gardners/megaphone-r5-modular/fonts/noto/README.txt

To download these fonts go to:

https://fonts.google.com/noto/specimen/Noto+Emoji

Then click on "Get Font", then "Download All (3)".

It's annoying that there is no direct link for them!
