gardners/megaphone-r5-modular/modules/bluetooth/footprints/BM83SM1-00AA.step

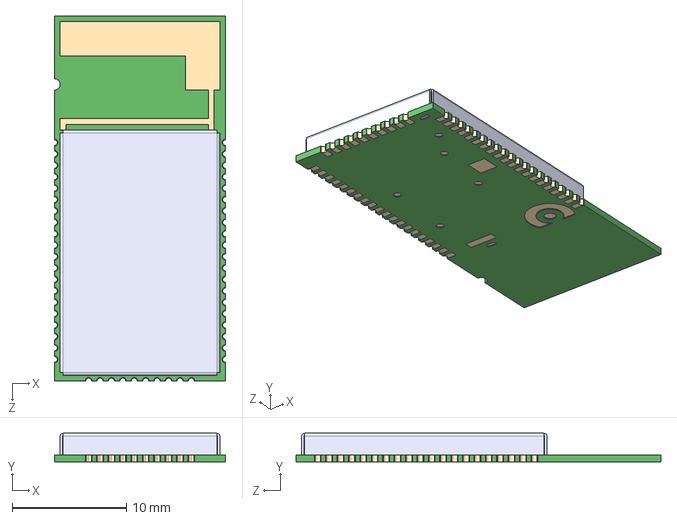
[picture p1: CAD file, 2025-04-25]
modules/bluetooth/footprints/BM83SM1-00AA.step
15.0 x 2.50 x 32.0 mm
