gardners/megaphone-r5-modular/modules/input-power-selector/footprints/SOIC_09DY-T1-GE3_VIS.step

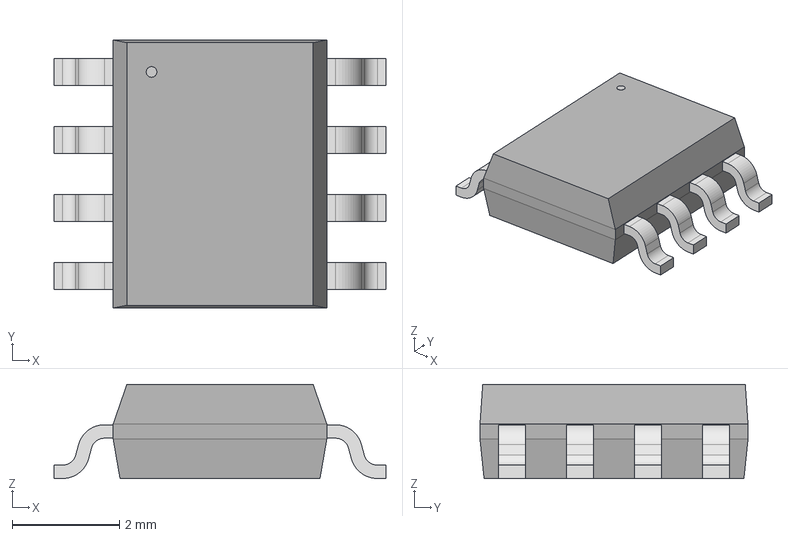
[picture p2: CAD file, 2025-03-04]
modules/input-power-selector/footprints/SOIC_09DY-T1-GE3_VIS.step
6.20 x 5.00 x 1.75 mm
