gardners/megaphone-r5-modular/modules/solar-and-dc-connectors/footprints/54-00127.step

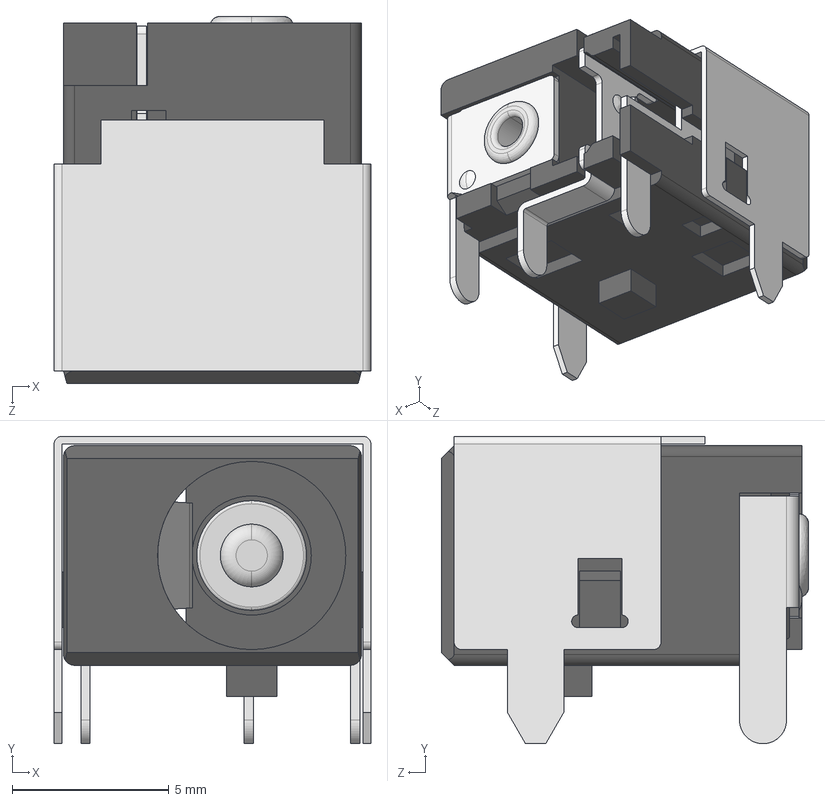
[picture p3: CAD file, 2025-03-05]
modules/solar-and-dc-connectors/footprints/54-00127.step
10.1 x 9.80 x 11.7 mm
