gardners/megaphone-r5-modular/modules/input-power-selector/footprints/SMCJSeries_LTF.step

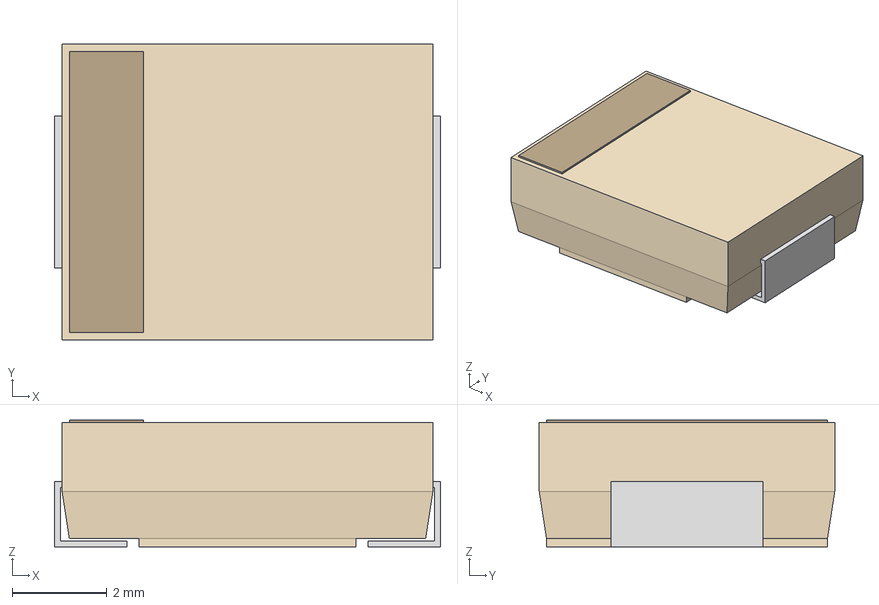
[picture p4: CAD file, 2025-03-04]
modules/input-power-selector/footprints/SMCJSeries_LTF.step
8.13 x 6.22 x 2.67 mm
