gardners/megaphone-r5-modular/modules/solar-and-dc-connectors/footprints/S2B-PH-K-S.STEP

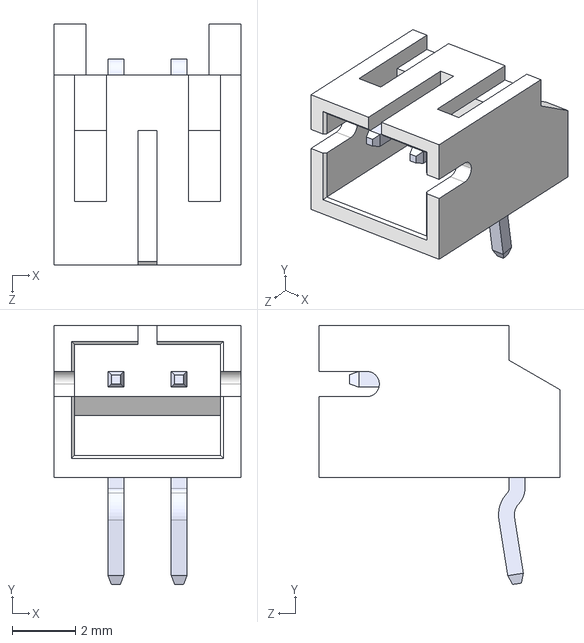
[picture p5: CAD file, 2025-03-05]
modules/solar-and-dc-connectors/footprints/S2B-PH-K-S.STEP
5.90 x 8.18 x 7.60 mm
