gardners/megaphone-r5-modular/modules/input-power-selector/footprints/BZX384-C30_115.step

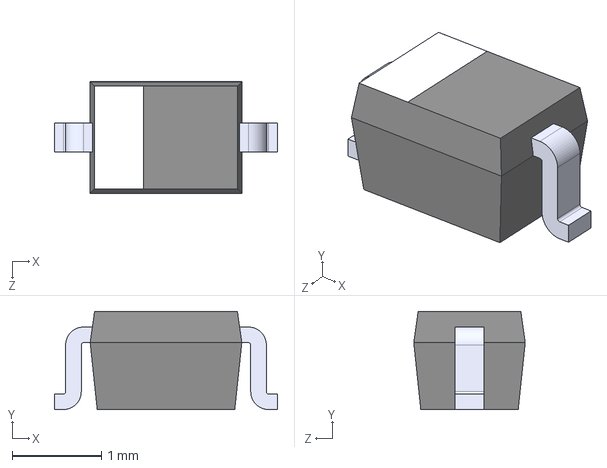
[picture p8: CAD file, 2025-03-02]
modules/input-power-selector/footprints/BZX384-C30_115.step
2.50 x 1.10 x 1.25 mm
