gardners/megaphone-r5-modular/modules/input-power-selector/footprints/SMM4F24A-TR.step

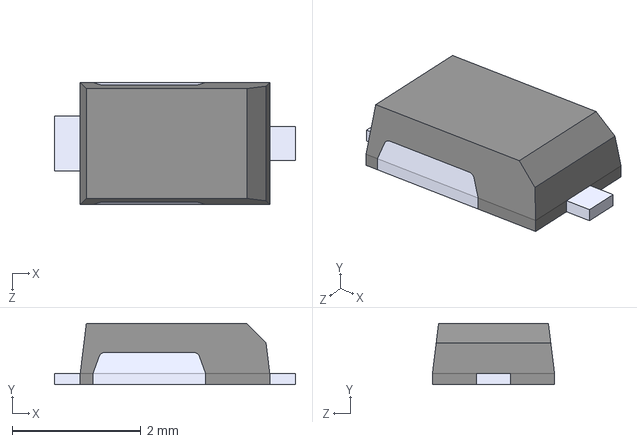
[picture p9: CAD file, 2025-03-01]
modules/input-power-selector/footprints/SMM4F24A-TR.step
3.75 x 0.95 x 1.90 mm
