gardners/megaphone-r5-modular/modules/input-power-selector/footprints/IPF067N20NM6ATMA1.stp

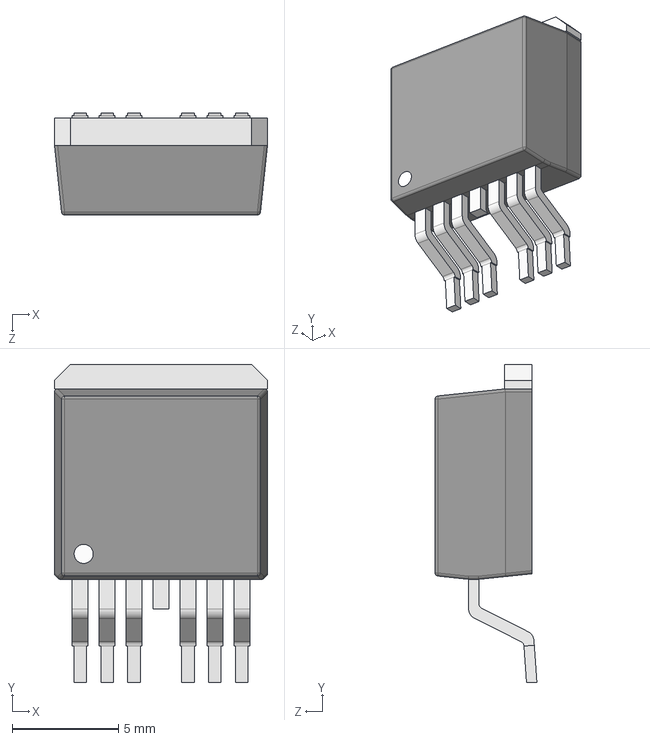
[picture p10: CAD file, 2025-03-01]
modules/input-power-selector/footprints/IPF067N20NM6ATMA1.stp
10.1 x 15.0 x 4.80 mm
