gardners/megaphone-r5-modular/modules/battery-connector/footprints/691210910002.step

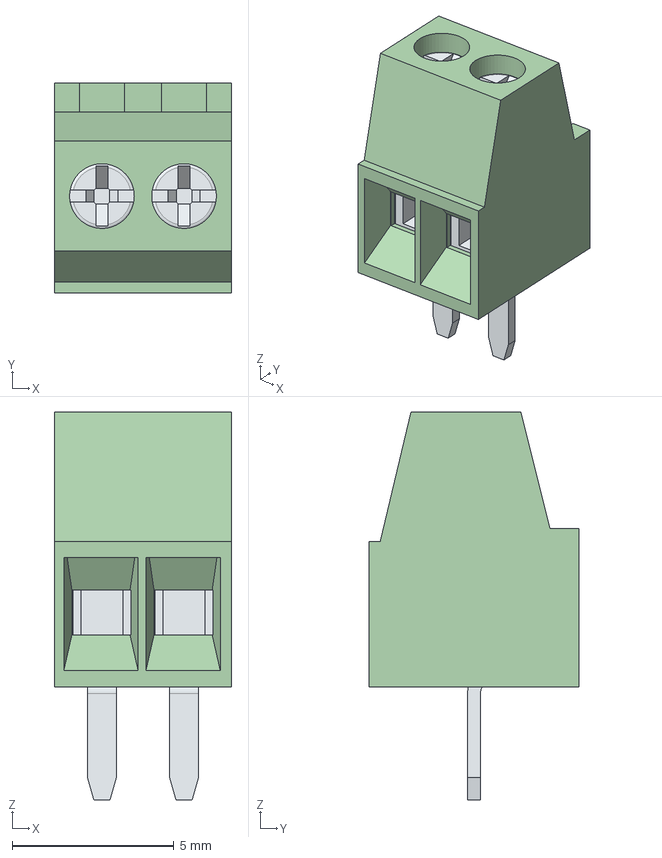
[picture p12: CAD file, 2025-03-05]
modules/battery-connector/footprints/691210910002.step
5.48 x 6.50 x 12.0 mm
6912109100xx_CAGE x 2
6912109100xx_PIN x 2
6912109100xx_VIS x 2
