gardners/megaphone-r5-modular/modules/lcd-panel/5051100692.stp

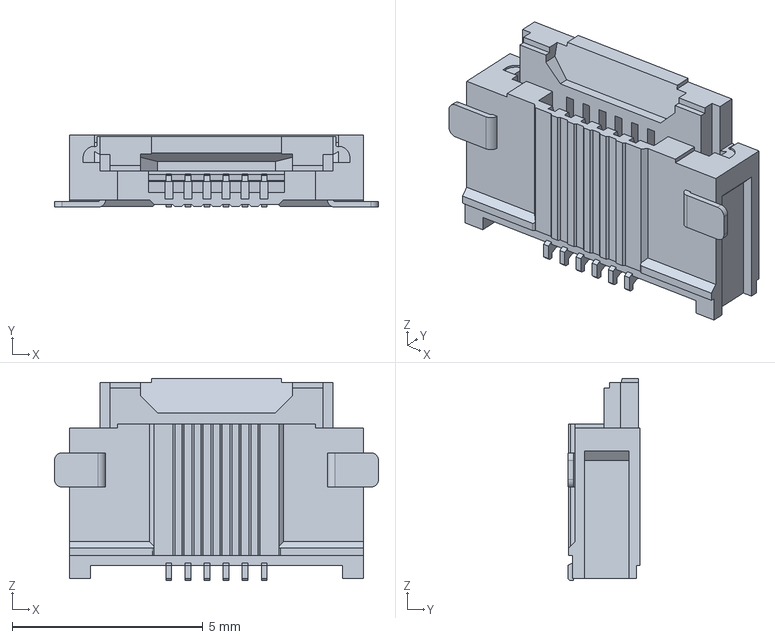
[picture p13: CAD file, 2025-04-25]
modules/lcd-panel/5051100692.stp
8.50 x 1.90 x 5.30 mm
