gardners/megaphone-r5-modular/modules/lcd-panel/5051104091.stp

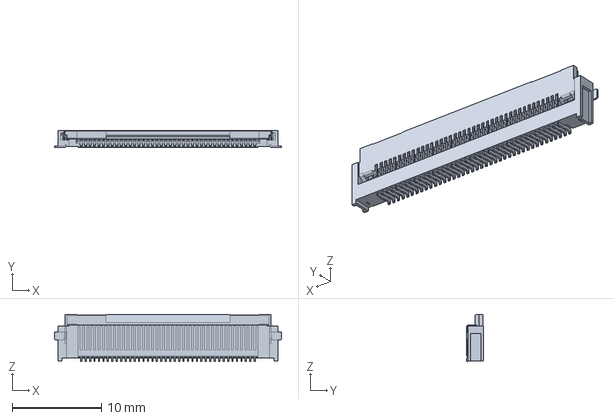
[picture p14: CAD file, 2025-04-25]
modules/lcd-panel/5051104091.stp
25.5 x 1.90 x 5.30 mm
