gardners/megaphone-r5-modular/modules/input-power-selector/input-power-selector.kicad_pcb

## KiCad design modules/input-power-selector/input-power-selector.kicad_pcb (2025-06-13)

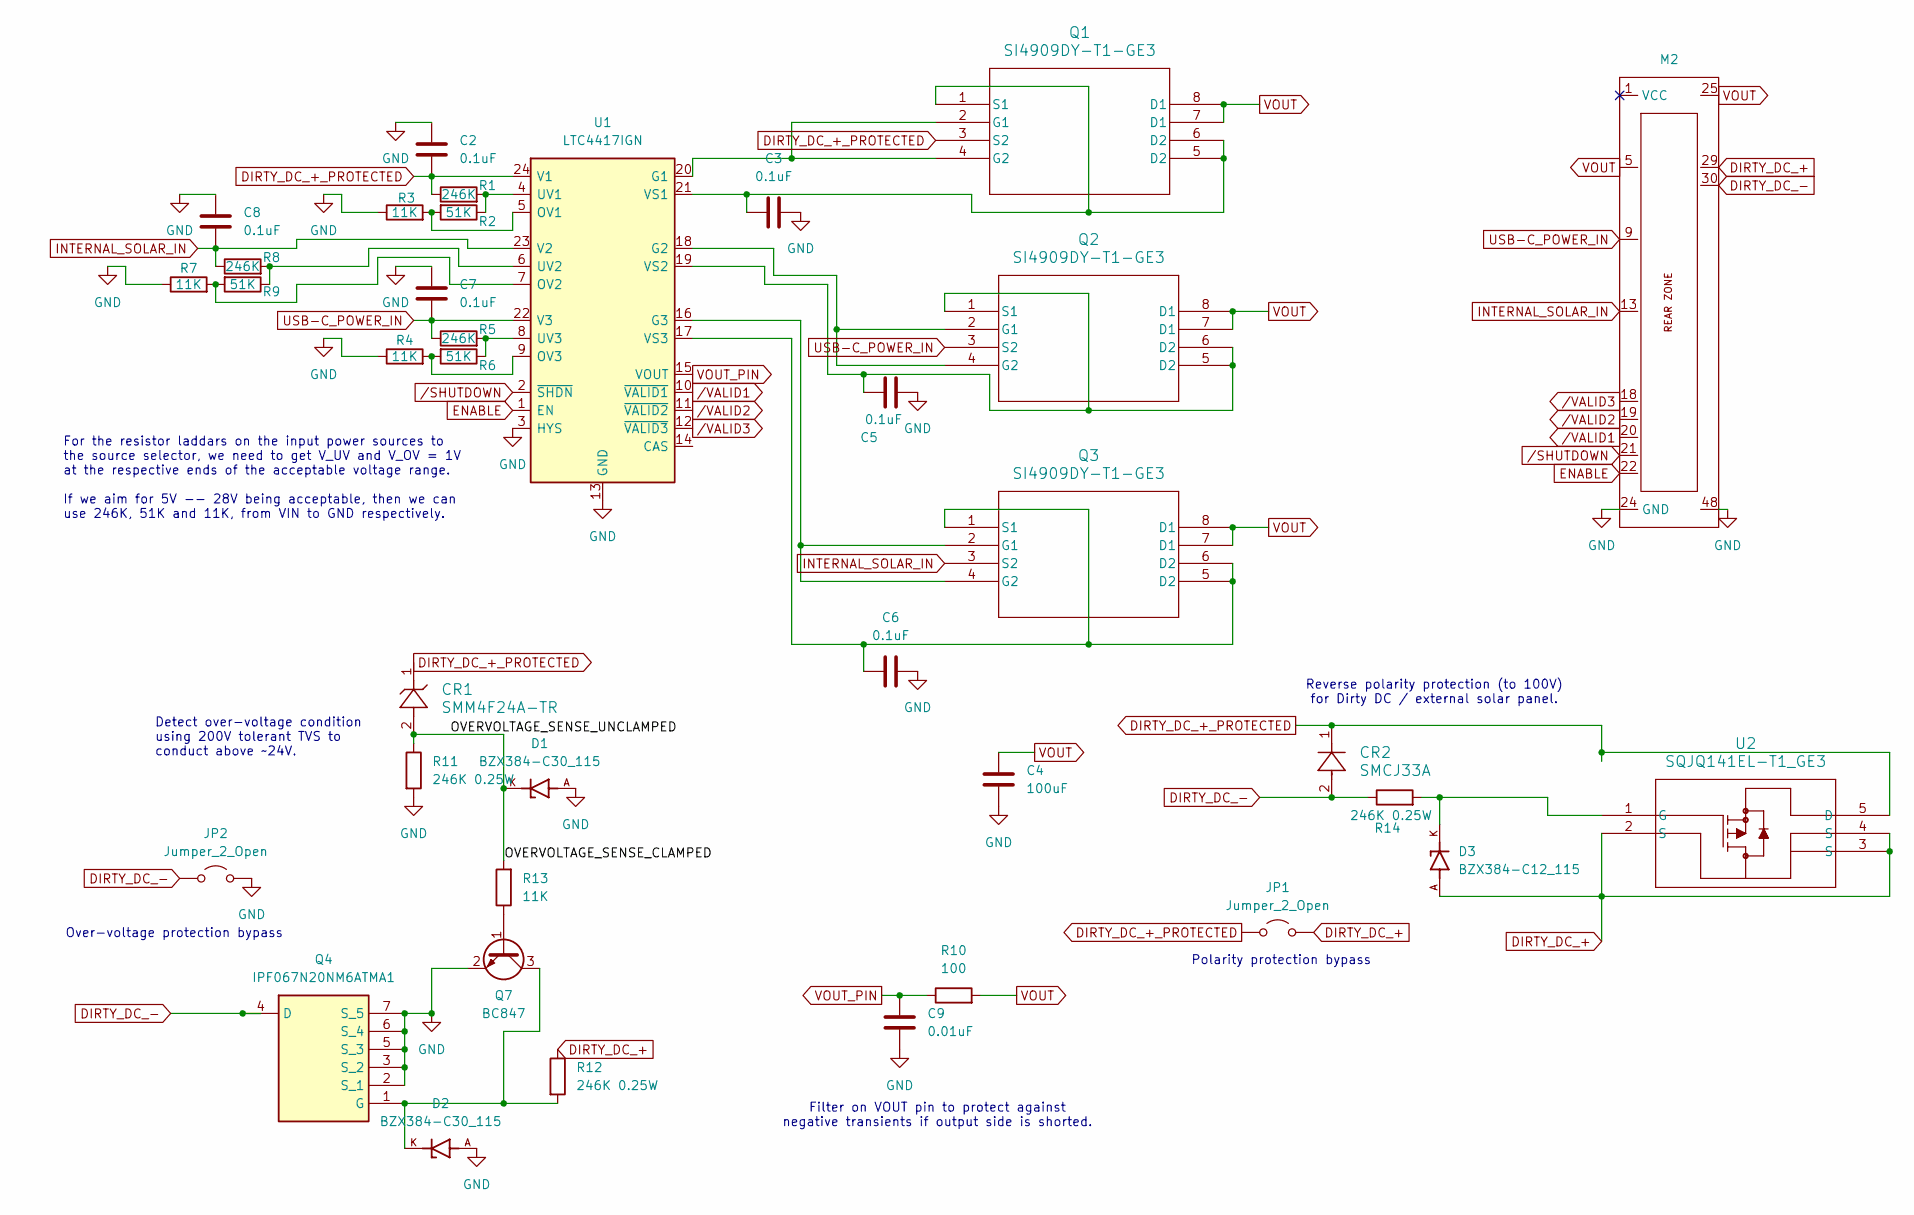
[picture p15: schematic input-power-selector.kicad_sch]

Parts:
C2, C3, C5, C6, C7, C8: 0.1uF; C_0805_2012Metric; Manufacturer_Part_Number 0805DC104MAT2A; Mouser Part Number 581-0805DC104MAT2A
C4: 100uF; C_0805_2012Metric
C9: 0.01uF; C_0805_2012Metric
CR1: SMM4F24A-TR; Manufacturer_Part_Number SMM4F24A-TR; Mouser Part Number 511-SMM4F24A-TR
CR2: SMCJ33A; Manufacturer_Part_Number 652-SMCJ33A; Mouser Part Number SMCJ33A
D1, D2: BZX384-C30_115; DIO_BZX384-C30_115; Manufacturer_Part_Number BZX384-C30,115; Mouser Part Number 771-BZX384-C30115
D3: BZX384-C12_115; DIO_BZX384-C30_115; Manufacturer_Part_Number BZX384-C12,115; Mouser Part Number 771-BZX384-C12115
JP1, JP2: Jumper_2_Open; SolderJumper-2_P1.3mm_Open_RoundedPad1.0x1.5mm
M2: MegaCastle2x24-Module-I47.0x56.2-M88887D8C0001-SPAREPAD
Q1, Q2, Q3: SI4909DY-T1-GE3; Manufacturer_Part_Number SI4909DY-T1-GE3; Mouser Part Number 78-SI4909DY-T1-GE3
Q4: IPF067N20NM6ATMA1; Mouser Part Number 726-IPF067N20NM6ATMA
Q7: BC847; SOT-23; Manufacturer_Part_Number 637-BC847B; Mouser Part Number BC847B
R1, R5, R8: 246K; R_0805_2012Metric
R2, R6, R9: 51K; R_0805_2012Metric; Manufacturer_Part_Number RV0805FR-0751KL; Mouser Part Number 603-RV0805FR-0751KL
R3, R4, R7, R13: 11K; R_0805_2012Metric; Manufacturer_Part_Number RT0805DRE0711KL; Mouser Part Number 603-RT0805DRE0711KL
R10: 100; R_0805_2012Metric; Manufacturer_Part_Number PCF0805R-100RBI; Mouser Part Number 756-PCF0805R100RBI
R11, R12, R14: 246K 0.25W; R_0805_2012Metric; Manufacturer_Part_Number PTN0805E2463BST1; Mouser Part Number 71-PTN0805E2463BST1
U1: LTC4417IGN; SSOP-24_3.9x8.7mm_P0.635mm; Manufacturer_Part_Number LTC4417IGN#PBF; Mouser Part Number 584-LTC4417IGN#PBF
U2: SQJQ141EL-T1_GE3; SOT95P280X120-6N; Manufacturer_Part_Number SQJQ141EL-T1_GE3; Mouser Part Number 78-SQJQ141EL-T1_GE3

Connections:
/OVERVOLTAGE_SENSE_CLAMPED: CR1.2, D1.K, R11.1, R13.2
DIRTY_DC_+: D3.A, JP1.2 (B), M2.29, R12.1, U2.2 (S), U2.3 (S), U2.4 (S)
DIRTY_DC_+_PROTECTED: C2.2, CR1.1, CR2.1, JP1.1 (A), Q1.3 (S2), R1.1, U1.24 (V1), U2.5 (D)
DIRTY_DC_-: CR2.2, JP2.1 (A), M2.30, Q4.4 (D), R14.1
ENABLE: M2.22, U1.1 (EN)
GND: C2.1, C3.2, C4.2, C5.2, C6.2, C7.1, C8.1, C9.2, D1.A, D2.A, JP2.2 (B), M2.24 (GND), M2.48, Q4.2 (S_1), Q4.3 (S_2), Q4.5 (S_3), Q4.6 (S_4), Q4.7 (S_5), Q7.2 (E), R3.1, R4.1, R7.1, R11.2, U1.3 (HYS), U1.13 (GND)
INTERNAL_SOLAR_IN: C8.2, M2.13, Q3.3 (S2), R8.1, U1.23 (V2)
unnamed: Q1.2 (G1), Q1.4 (G2), U1.20 (G1)
unnamed: C3.1, Q1.1 (S1), Q1.5 (D2), Q1.6 (D2), U1.21 (VS1)
unnamed: Q2.2 (G1), Q2.4 (G2), U1.18 (G2)
unnamed: C5.1, Q2.1 (S1), Q2.5 (D2), Q2.6 (D2), U1.19 (VS2)
unnamed: Q3.2 (G1), Q3.4 (G2), U1.16 (G3)
unnamed: C6.1, Q3.1 (S1), Q3.5 (D2), Q3.6 (D2), U1.17 (VS3)
unnamed: D2.K, Q4.1 (G), Q7.3 (C), R12.2
unnamed: Q7.1 (B), R13.1
unnamed: R2.2, R3.2, U1.5 (OV1)
unnamed: R7.2, R9.2, U1.7 (OV2)
unnamed: R4.2, R6.2, U1.9 (OV3)
unnamed: R1.2, R2.1, U1.4 (UV1)
unnamed: R8.2, R9.1, U1.6 (UV2)
unnamed: R5.2, R6.1, U1.8 (UV3)
unnamed: D3.K, R14.2, U2.1 (G)
USB-C_POWER_IN: C7.2, M2.9, Q2.3 (S2), R5.1, U1.22 (V3)
VOUT: C4.1, M2.5, M2.25, Q1.7 (D1), Q1.8 (D1), Q2.7 (D1), Q2.8 (D1), Q3.7 (D1), Q3.8 (D1), R10.2
VOUT_PIN: C9.1, R10.1, U1.15 (VOUT)
/SHUTDOWN: M2.21, U1.2 (~SHDN)
/VALID1: M2.20, U1.10 (~VALID1)
/VALID2: M2.19, U1.11 (~VALID2)
/VALID3: M2.18, U1.12 (~VALID3)

Notes on the sheet:
For the resistor laddars on the input power sources to the source selector, we need to get V_UV and V_OV = 1V at the respective ends of the acceptable voltage range. If we aim for 5V -- 28V being acceptable, then we can use 246K, 51K and 11K, from VIN to GND respectively.
Filter on VOUT pin to protect against negative transients if output side is shorted.
Reverse polarity protection (to 100V) for Dirty DC / external solar panel.
Over-voltage protection bypass
Detect over-voltage condition using 200V tolerant TVS to conduct above ~24V.
Polarity protection bypass

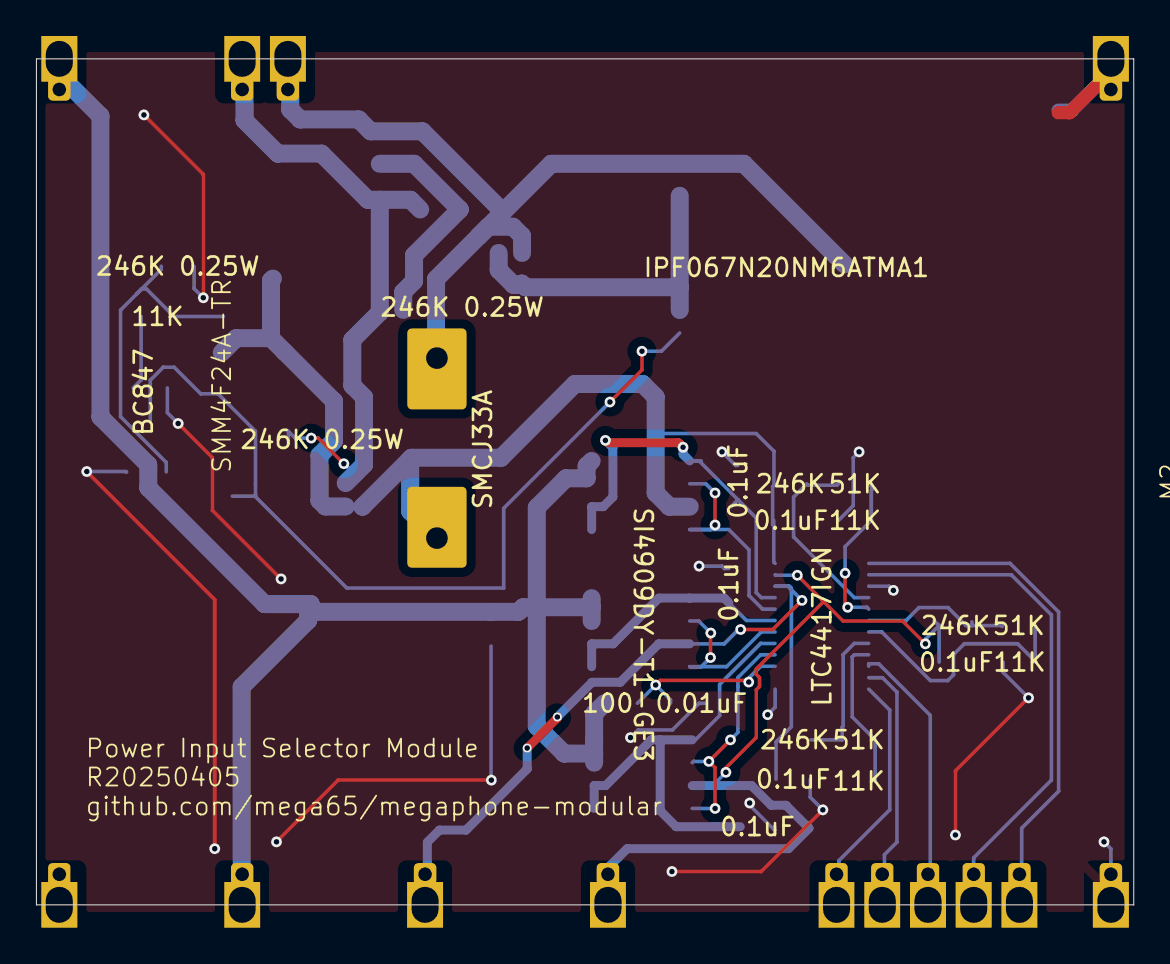
[picture p16: board input-power-selector.kicad_pcb from above]

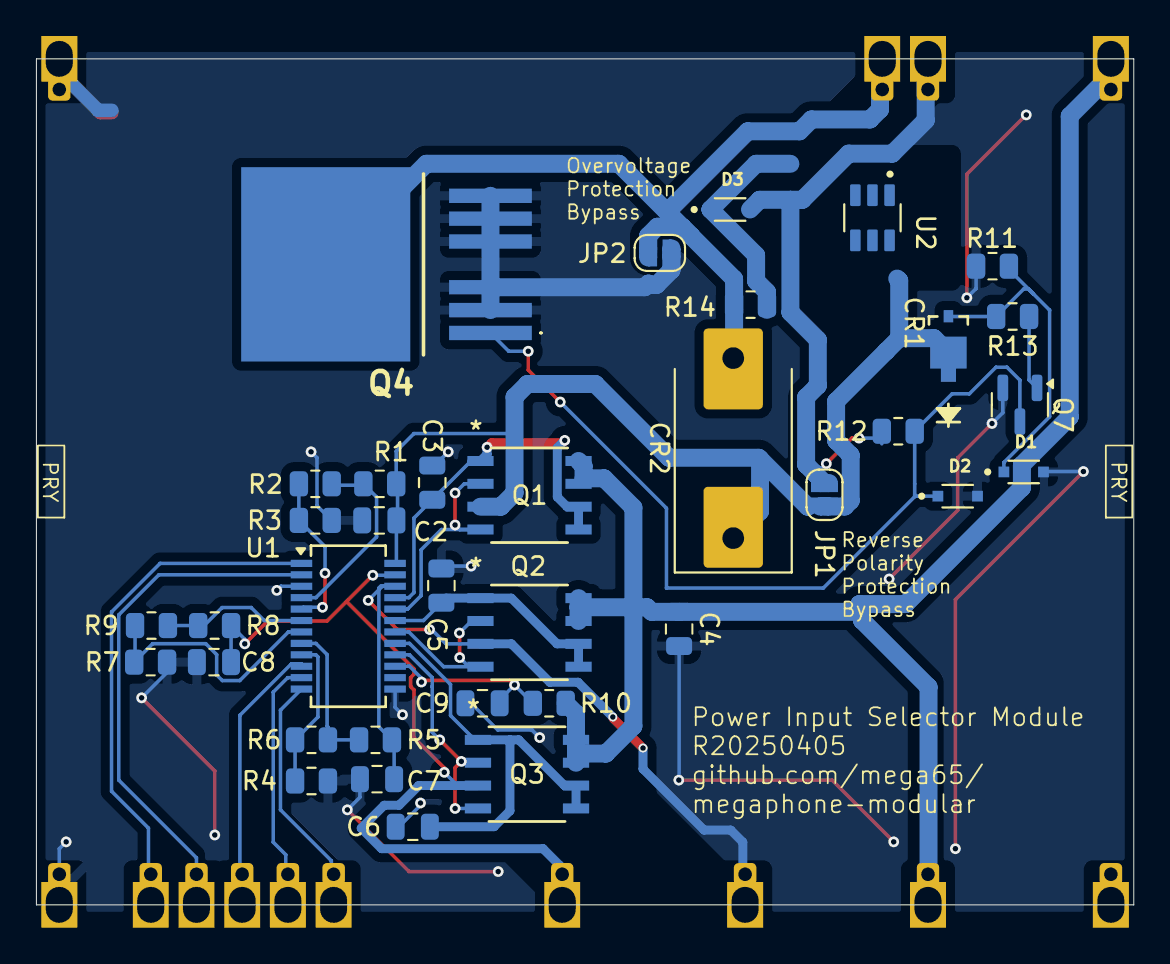
[picture p17: board input-power-selector.kicad_pcb from below]

Board: 2 copper layers, 61.0 x 47.0 mm, 37 parts (36 on the bottom side), 29 nets.
