gardners/megaphone-r5-modular/modules/mems-microphone/mems-microphone.kicad_pcb

## KiCad design modules/mems-microphone/mems-microphone.kicad_pcb (2025-06-13)

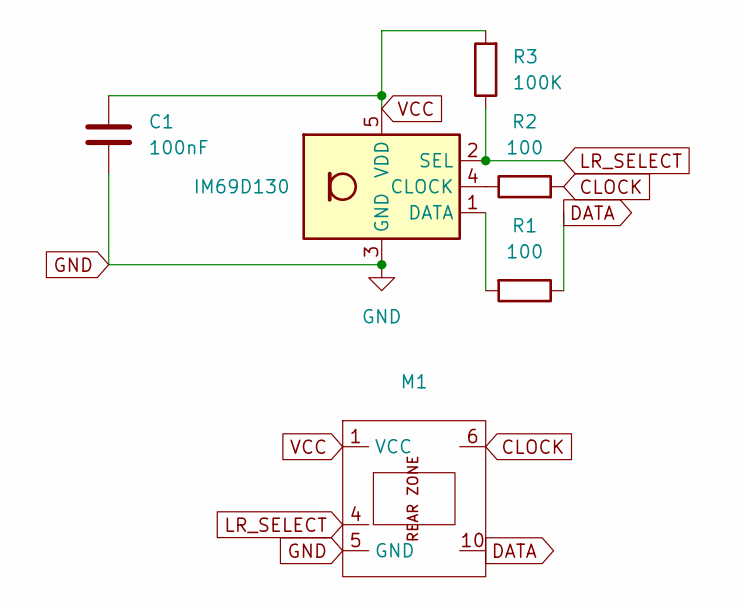
[picture p18: schematic mems-microphone.kicad_sch]

Parts:
C1: 100nF; C_1206_3216Metric; Mouser PN 581-12066D104KAT4A
M1: MegaCastle2x5-Module-I10.0x7.9-M9C4-SPAREPAD
MK1: IM69D130; Knowles_LGA-5_3.5x2.65mm; Mouser PN 726-IM69D130V01XTSA1
R1: 100; R_0603_1608Metric; Mfr. PN AC0603JR-07100RL; Mouser PN 603-AC0603JR-07100RL
R2: 100; R_0603_1608Metric; Mouser PN 603-AC0603JR-07100RL
R3: 100K; R_0603_1608Metric; Mouser PN 603-AC0603JR-07100KL

Connections:
CLOCK: M1.6, R2.2
DATA: M1.10, R1.1
GND: C1.2, M1.5 (GND), MK1.3 (GND)
LR_SELECT: M1.4, MK1.2 (SEL), R3.1
unnamed: MK1.4 (CLOCK), R2.1
unnamed: MK1.1 (DATA), R1.2
VCC: C1.1, M1.1 (VCC), MK1.5 (VDD), R3.2

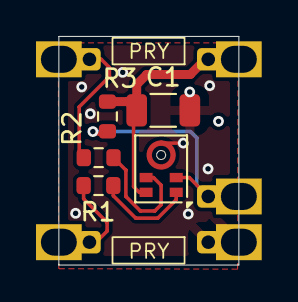
[picture p19: board mems-microphone.kicad_pcb from above]

Board: 2 copper layers, 10.0 x 12.7 mm, 6 parts (1 on the bottom side), 7 nets.
