gardners/megaphone-r5-modular/modules/high-efficiency_dc-dc_converter/high-efficiency_dc-dc_converter.kicad_pcb

## KiCad design modules/high-efficiency_dc-dc_converter/high-efficiency_dc-dc_converter.kicad_pcb (2025-06-13)

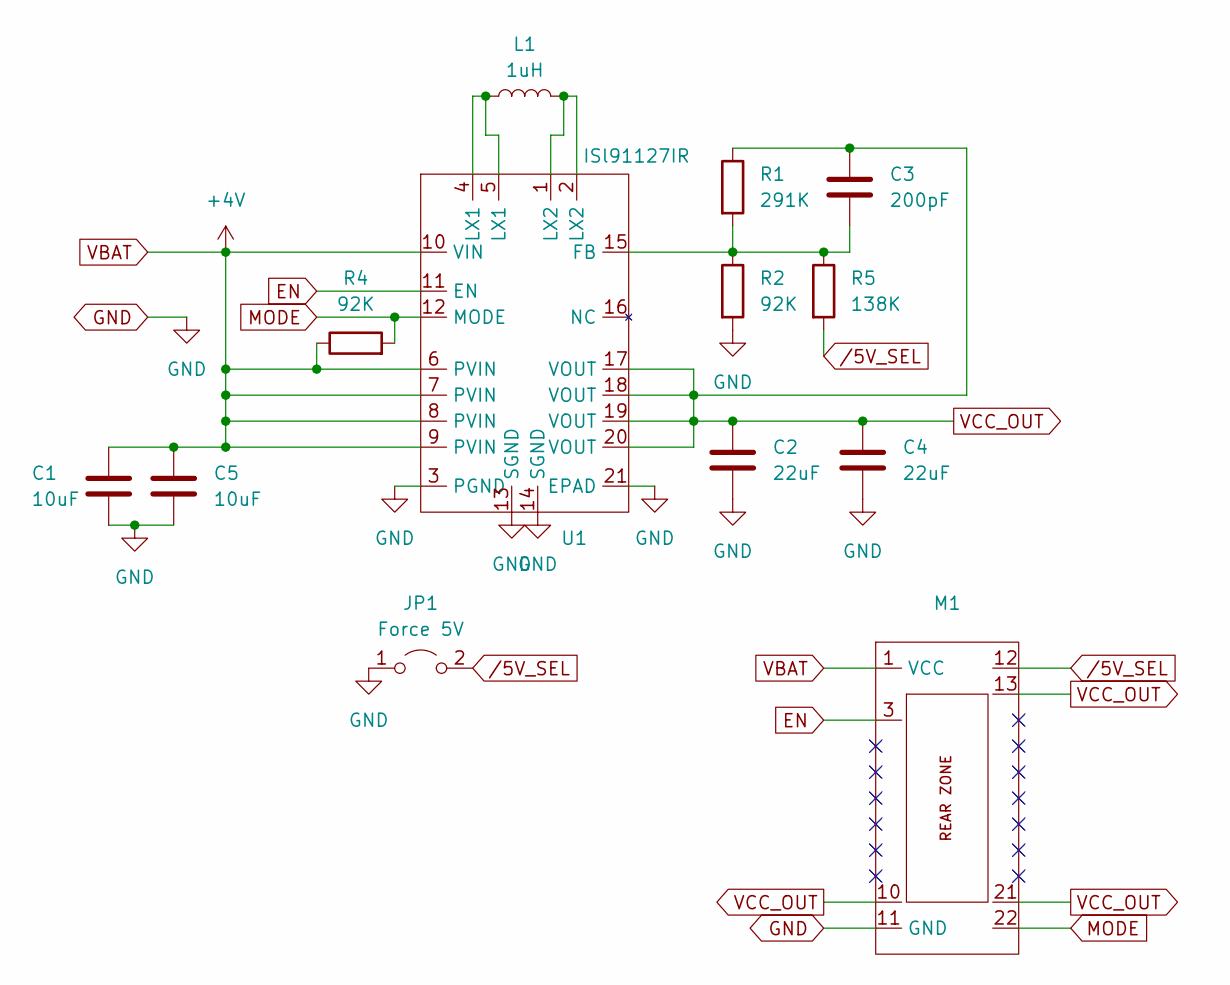
[picture p20: schematic high-efficiency_dc-dc_converter.kicad_sch, High-Efficiency DC:DC Converter Module]

Parts:
C1, C5: 10uF; C_0805_2012Metric
C2, C4: 22uF; C_0805_2012Metric
C3: 200pF; C_0805_2012Metric
JP1: Force 5V; SolderJumper-2_P1.3mm_Open_RoundedPad1.0x1.5mm
L1: 1uH; L_1008_2520Metric
M1: MegaCastle2x11-Module-I15.7x23.1-MA0780C-PANEL-NIBBLE
R1: 291K; R_0603_1608Metric
R2, R4: 92K; R_0603_1608Metric; Mouser PN 660-RN73H1JTD9202B25
R5: 138K; R_0603_1608Metric
U1: ISl91127IR; QFN50P400X400X90-21N; Mouser PN 968-ISL91127IRAZ-T

Connections:
EN: M1.3, U1.11 (EN)
GND: C1.2, C2.2, C4.2, C5.2, JP1.1 (A), M1.11 (GND), R2.2, U1.3 (PGND), U1.13 (SGND), U1.14 (SGND), U1.21 (EPAD)
MODE: M1.22, R4.2, U1.12 (MODE)
unnamed: L1.1, U1.4 (LX1), U1.5 (LX1)
unnamed: L1.2, U1.1 (LX2), U1.2 (LX2)
unnamed: C3.2, R1.2, R2.1, R5.1, U1.15 (FB)
VBAT: C1.1, C5.1, M1.1 (VCC), R4.1, U1.6 (PVIN), U1.7 (PVIN), U1.8 (PVIN), U1.9 (PVIN), U1.10 (VIN)
VCC_OUT: C2.1, C3.1, C4.1, M1.10, M1.13, M1.21, R1.1, U1.17 (VOUT), U1.18 (VOUT), U1.19 (VOUT), U1.20 (VOUT)
/5V_SEL: JP1.2 (B), M1.12, R5.2

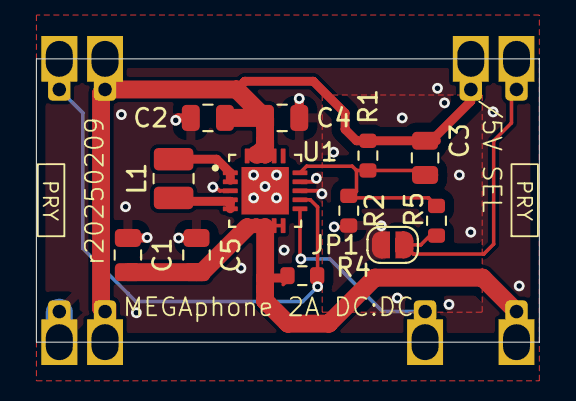
[picture p21: board high-efficiency_dc-dc_converter.kicad_pcb from above]

Board: 2 copper layers, 27.9 x 15.7 mm, 13 parts (1 on the bottom side), 9 nets.
