gardners/megaphone-r5-modular/modules/cellular-modem/cellular-modem.kicad_pcb

## KiCad design modules/cellular-modem/cellular-modem.kicad_pcb (2025-06-13)

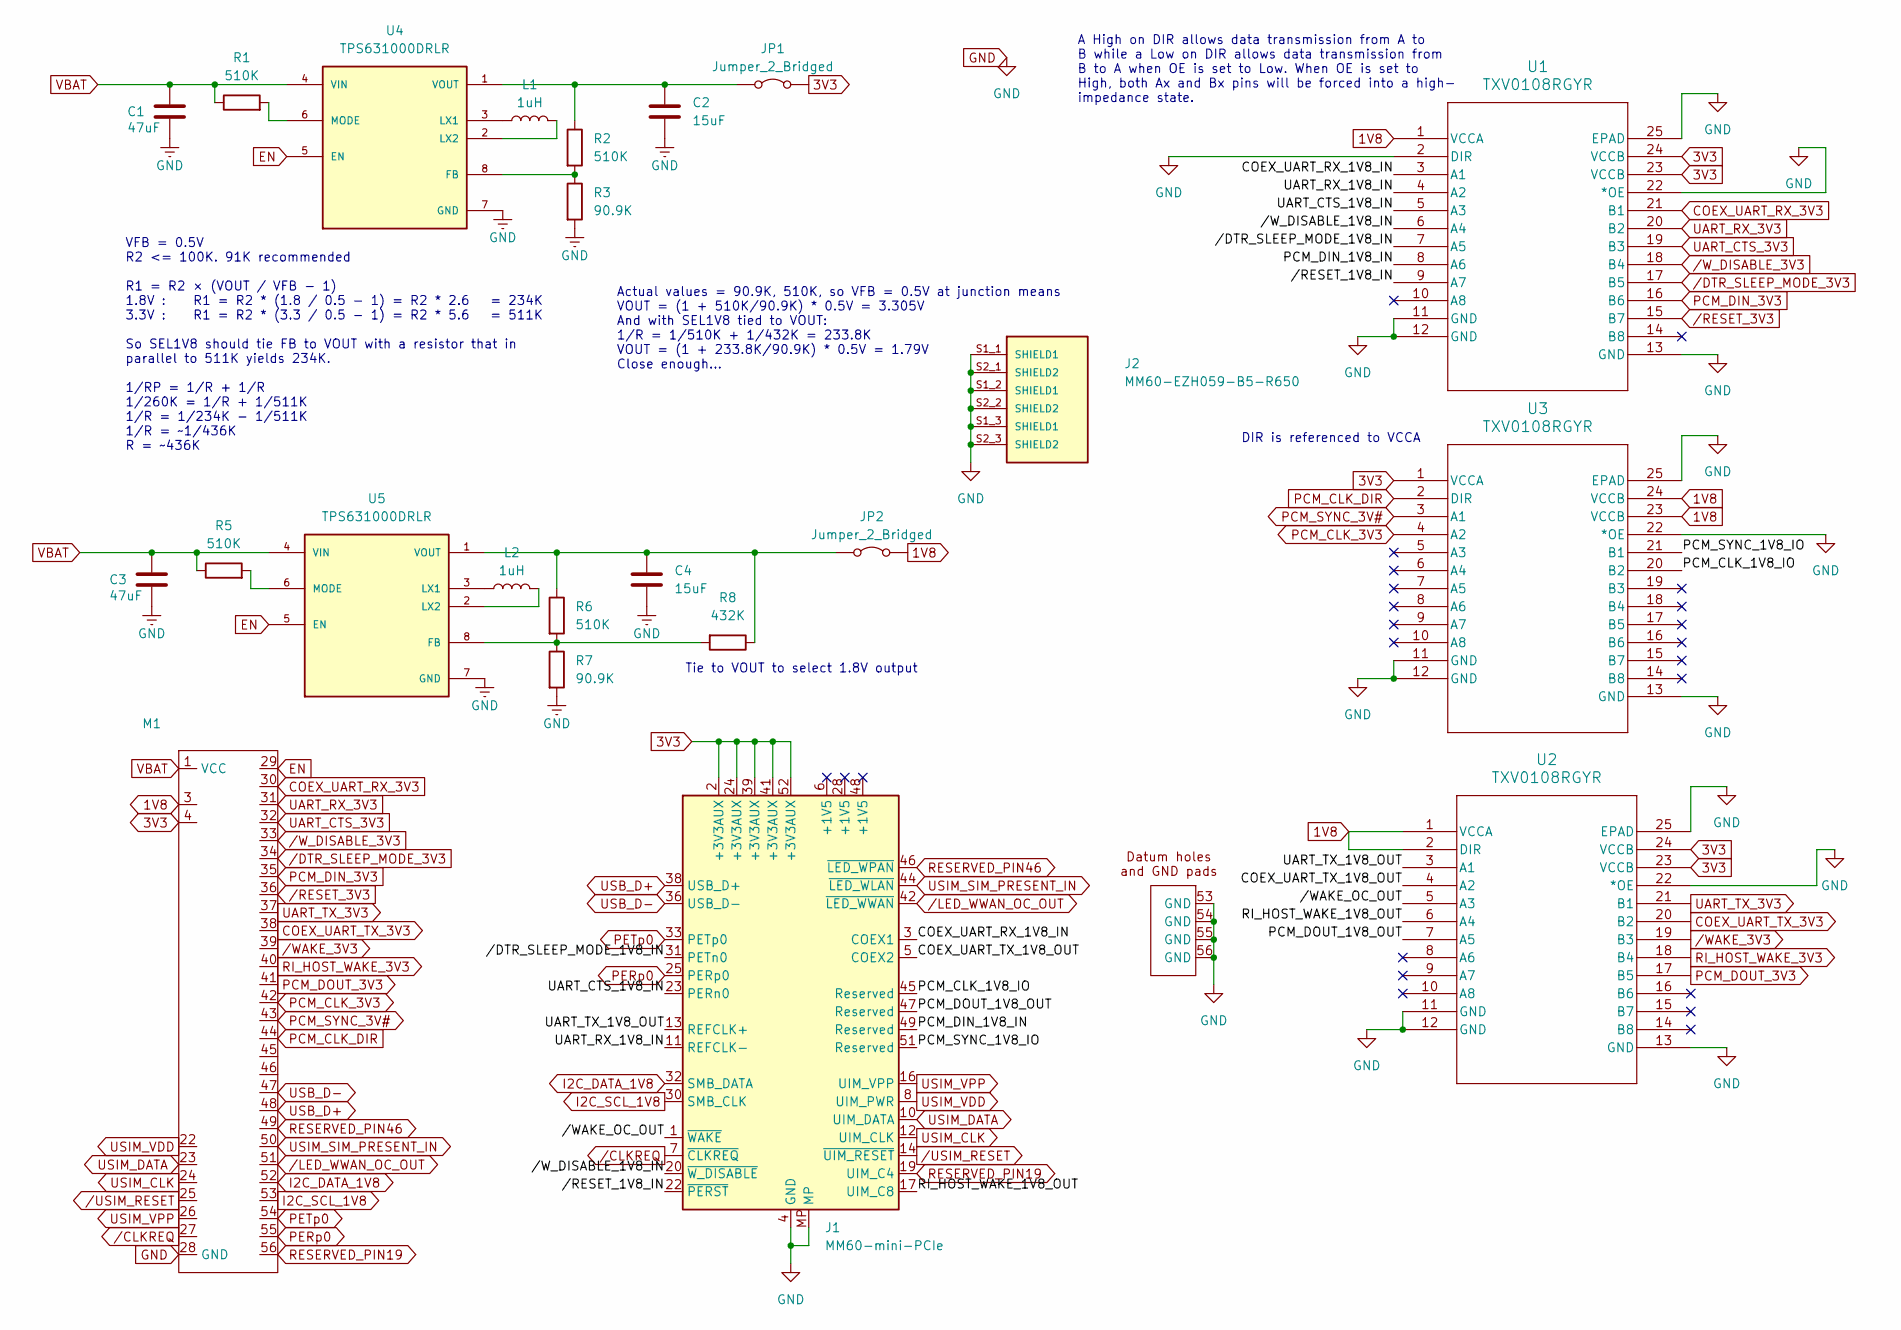
[picture p22: schematic cellular-modem.kicad_sch]

Parts:
C1: 47uF; C_0805_2012Metric; Mouser_PN GRM219R60J476ME44
C2, C4: 15uF; C_0805_2012Metric; Mfr. PN C2012X7S1A156M125AC; Mouser_PN 810-C2012X7S1A156M1C
C3: 47uF; C_0805_2012Metric; Mfr. PN GRM219R60J476ME44D; Mouser_PN GRM219R60J476ME44
J1: MM60-mini-PCIe; CONN_MM60-52B1-E1-R650_JAE; Mfr. PN MM60-52B1-G1-R850; Mouser_PN 656-MM6052B1G1R850
J2: MM60-EZH059-B5-R650; JAE_MM60-EZH059-B5-R650; PARTREV 3; Mouser_PN 656-MM60-EZH059-B5-R
JP1, JP2: Jumper_2_Bridged; SolderJumper-2_P1.3mm_Bridged2Bar_RoundedPad1.0x1.5mm
L1: 1uH; L_1008_2520Metric_Pad1.43x2.20mm_HandSolder; Mouser_PN 81-DFE252012P-1R0MP2
L2: 1uH; L_1008_2520Metric_Pad1.43x2.20mm_HandSolder; Mfr. PN DFE252012P-1R0M=P2; Mouser_PN 81-DFE252012P-1R0MP2
M1: MegaCastle2x28-Module-I42.8x66.3-MB00007FFFFFFFF-SPAREPAD
R1, R2, R5, R6: 510K; R_0805_2012Metric; Mouser_PN CR0805-JW-514ELF
R3, R7: 90.9K; R_0805_2012Metric; Mfr. PN RE0805FRE0790K9L; Mouser_PN 603-RE0805FRE0790K9L
R8: 432K; R_0805_2012Metric; Mfr. PN RC0805FR-07432KL; Mouser_PN 603-RC0805FR-07432KL
U1, U2, U3: TXV0108RGYR; VQFN24_RGY_TEX; Mfr. PN TXV0108RGYR; Mouser_PN 595-TXV0108RGYR
U4, U5: TPS631000DRLR; SOT50P160X60-8N; PARTREV B; Mouser_PN 595-TPS631000DRLR

Connections:
1V8: JP2.2 (B), M1.3, U1.1 (VCCA), U2.1 (VCCA), U2.2 (DIR), U3.23 (VCCB), U3.24 (VCCB)
3V3: J1.2 (+3V3AUX), J1.24 (+3V3AUX), J1.39 (+3V3AUX), J1.41 (+3V3AUX), J1.52 (+3V3AUX), JP1.2 (B), M1.4, U1.23 (VCCB), U1.24 (VCCB), U2.23 (VCCB), U2.24 (VCCB), U3.1 (VCCA)
/COEX_UART_RX_1V8_IN: J1.3 (COEX1), U1.3 (A1)
/COEX_UART_TX_1V8_OUT: J1.5 (COEX2), U2.4 (A2)
/PCM_CLK_1V8_IO: J1.45 (Reserved), U3.20 (B2)
/PCM_DIN_1V8_IN: J1.49 (Reserved), U1.8 (A6)
/PCM_DOUT_1V8_OUT: J1.47 (Reserved), U2.7 (A5)
/PCM_SYNC_1V8_IO: J1.51 (Reserved), U3.21 (B1)
/RI_HOST_WAKE_1V8_OUT: J1.17 (UIM_C8), U2.6 (A4)
/UART_CTS_1V8_IN: J1.23 (PERn0), U1.5 (A3)
/UART_RX_1V8_IN: J1.11 (REFCLK-), U1.4 (A2)
/UART_TX_1V8_OUT: J1.13 (REFCLK+), U2.3 (A1)
//DTR_SLEEP_MODE_1V8_IN: J1.31 (PETn0), U1.7 (A5)
//RESET_1V8_IN: J1.22 (~PERST), U1.9 (A7)
//WAKE_OC_OUT: J1.1 (~WAKE), U2.5 (A3)
//W_DISABLE_1V8_IN: J1.20 (~W_DISABLE), U1.6 (A4)
COEX_UART_RX_3V3: M1.30, U1.21 (B1)
COEX_UART_TX_3V3: M1.38, U2.20 (B2)
EN: M1.29, U4.5 (EN), U5.5 (EN)
GND: C1.1, C2.2, C3.1, C4.2, J1.4 (GND), J1.9 (GND), J1.15 (GND), J1.18 (GND), J1.21 (GND), J1.26 (GND), J1.27 (GND), J1.29 (GND), J1.34 (GND), J1.35 (GND), J1.37 (GND), J1.40 (GND), J1.43 (GND), J1.50 (GND), J1.53 (GND), J1.54 (GND), J1.55 (GND), J1.56 (GND), J1.MP, J2.S1_1 (SHIELD1), J2.S1_2 (SHIELD1), J2.S1_3 (SHIELD1), J2.S2_1 (SHIELD2), J2.S2_2 (SHIELD2), J2.S2_3 (SHIELD2), M1.28 (GND), R3.2, R7.2, U1.2 (DIR), U1.11 (GND), U1.12 (GND), U1.13 (GND), U1.22 (*OE), U1.25 (EPAD), U2.11 (GND), U2.12 (GND), U2.13 (GND), U2.22 (*OE), U2.25 (EPAD), U3.11 (GND), U3.12 (GND), U3.13 (GND), U3.22 (*OE), U3.25 (EPAD), U4.7 (GND), U5.7 (GND)
I2C_DATA_1V8: J1.32 (SMB_DATA), M1.52
I2C_SCL_1V8: J1.30 (SMB_CLK), M1.53
unnamed: C2.1, JP1.1 (A), R2.1, U4.1 (VOUT)
unnamed: C4.1, JP2.1 (A), R6.1, R8.1, U5.1 (VOUT)
unnamed: R2.2, R3.1, U4.8 (FB)
unnamed: L1.1, U4.3 (LX1)
unnamed: L1.2, U4.2 (LX2)
unnamed: R1.2, U4.6 (MODE)
unnamed: R6.2, R7.1, R8.2, U5.8 (FB)
unnamed: L2.1, U5.3 (LX1)
unnamed: L2.2, U5.2 (LX2)
unnamed: R5.2, U5.6 (MODE)
PCM_CLK_3V3: M1.42, U3.4 (A2)
PCM_CLK_DIR: M1.44, U3.2 (DIR)
PCM_DIN_3V3: M1.35, U1.16 (B6)
PCM_DOUT_3V3: M1.41, U2.17 (B5)
PCM_SYNC_3V#: M1.43, U3.3 (A1)
PERp0: J1.25 (PERp0), M1.55
PETp0: J1.33 (PETp0), M1.54
RESERVED_PIN19: J1.19 (UIM_C4), M1.56
RESERVED_PIN46: J1.46 (~LED_WPAN), M1.49
RI_HOST_WAKE_3V3: M1.40, U2.18 (B4)
UART_CTS_3V3: M1.32, U1.19 (B3)
UART_RX_3V3: M1.31, U1.20 (B2)
UART_TX_3V3: M1.37, U2.21 (B1)
USB_D+: J1.38 (USB_D+), M1.48
USB_D-: J1.36 (USB_D-), M1.47
USIM_CLK: J1.12 (UIM_CLK), M1.24
USIM_DATA: J1.10 (UIM_DATA), M1.23
USIM_SIM_PRESENT_IN: J1.44 (~LED_WLAN), M1.50
USIM_VDD: J1.8 (UIM_PWR), M1.22
USIM_VPP: J1.16 (UIM_VPP), M1.26
VBAT: C1.2, C3.2, M1.1 (VCC), R1.1, R5.1, U4.4 (VIN), U5.4 (VIN)
/CLKREQ: J1.7 (~CLKREQ), M1.27
/DTR_SLEEP_MODE_3V3: M1.34, U1.17 (B5)
/LED_WWAN_OC_OUT: J1.42 (~LED_WWAN), M1.51
/RESET_3V3: M1.36, U1.15 (B7)
/USIM_RESET: J1.14 (~UIM_RESET), M1.25
/WAKE_3V3: M1.39, U2.19 (B3)
/W_DISABLE_3V3: M1.33, U1.18 (B4)

Notes on the sheet:
Tie to VOUT to select 1.8V output
Actual values = 90.9K, 510K, so VFB = 0.5V at junction means VOUT = (1 + 510K/90.9K) * 0.5V = 3.305V And with SEL1V8 tied to VOUT: 1/R = 1/510K + 1/432K = 233.8K VOUT = (1 + 233.8K/90.9K) * 0.5V = 1.79V Close enough...
VFB = 0.5V R2 <= 100K. 91K recommended R1 = R2 × (VOUT / VFB - 1) 1.8V : R1 = R2 * (1.8 / 0.5 - 1) = R2 * 2.6 = 234K 3.3V : R1 = R2 * (3.3 / 0.5 - 1) = R2 * 5.6 = 511K So SEL1V8 should tie FB to VOUT with a resistor that in parallel to 511K yields 234K. 1/RP = 1/R + 1/R 1/260K = 1/R + 1/511K 1/R = 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
DIR is referenced to VCCA
A High on DIR allows data transmission from A to B while a Low on DIR allows data transmission from B to A when OE is set to Low. When OE is set to High, both Ax and Bx pins will be forced into a high- impedance state.

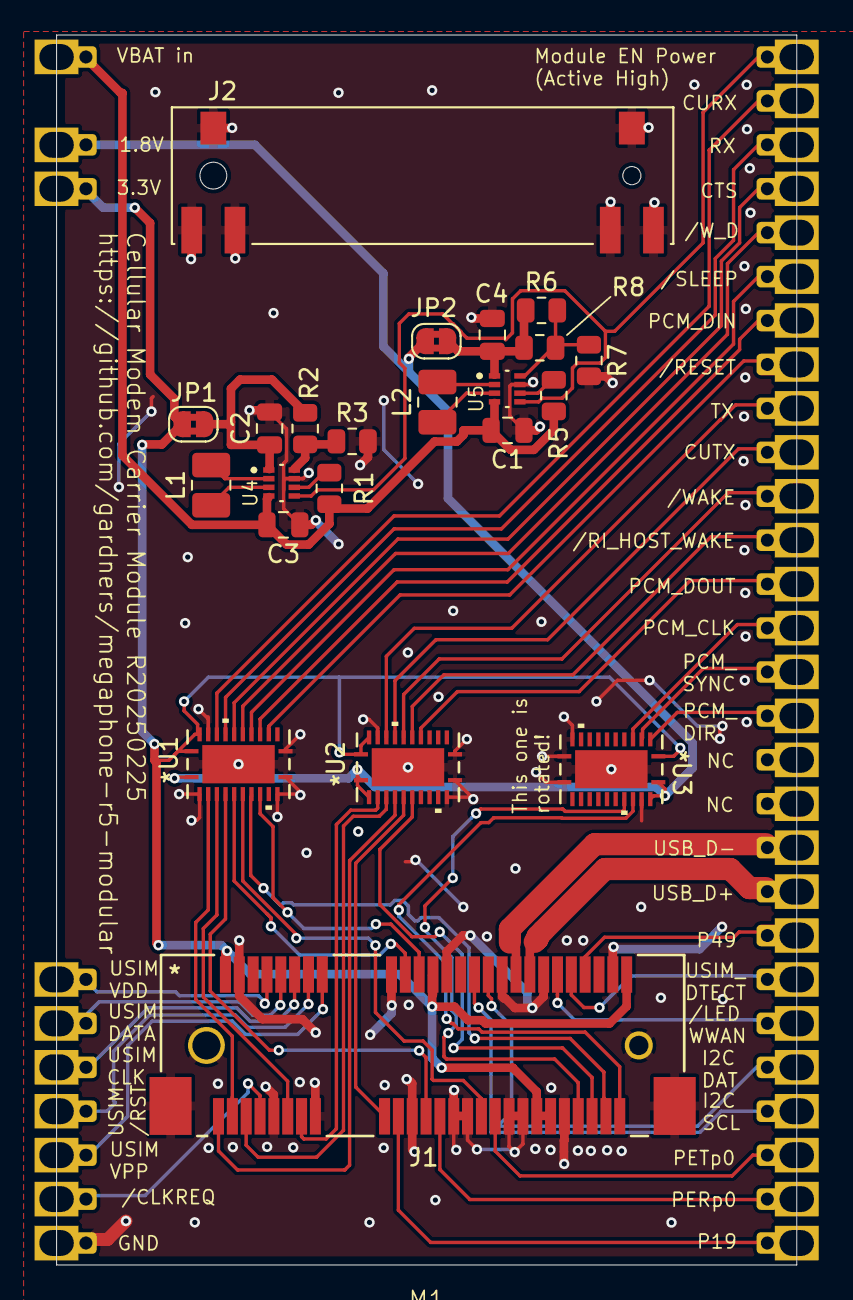
[picture p23: board cellular-modem.kicad_pcb from above]

Board: 4 copper layers, 42.8 x 71.1 mm, 23 parts (0 on the bottom side), 60 nets.
