gardners/megaphone-r5-modular/modules/solar-and-dc-connectors/solar-and-dc-connectors.kicad_pcb

## KiCad design modules/solar-and-dc-connectors/solar-and-dc-connectors.kicad_pcb (2025-06-13)

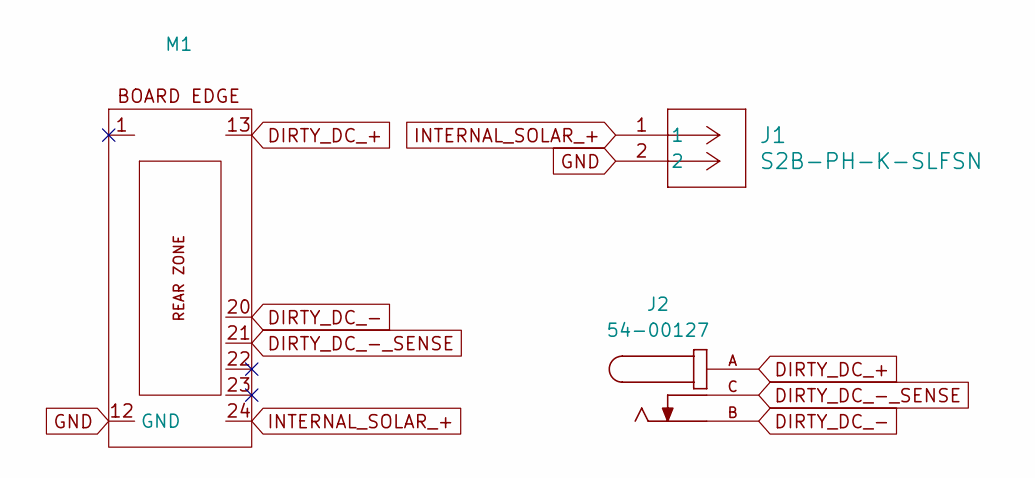
[picture p25: schematic solar-and-dc-connectors.kicad_sch]

Parts:
J1: S2B-PH-K-SLFSN; CONN_S2B-PH-K-S_JST; Mouser PN 306-S2BPHKSLFSNPP
J2: 54-00127; TENSILITY_54-00127; PARTREV A
M1: MegaCastle2x12-Module-I20.0x25.7-M80181F-SPAREPAD

Connections:
DIRTY_DC_+: J2.A, M1.13
DIRTY_DC_-: J2.B, M1.20
DIRTY_DC_-_SENSE: J2.C, M1.21
GND: J1.2, M1.12 (GND)
INTERNAL_SOLAR_+: J1.1, M1.24

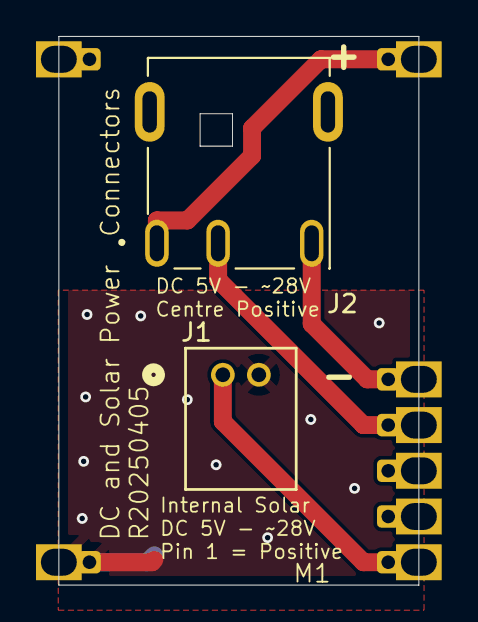
[picture p26: board solar-and-dc-connectors.kicad_pcb from above]

Board: 2 copper layers, 20.0 x 30.5 mm, 3 parts (0 on the bottom side), 5 nets.
