gardners/megaphone-r5-modular/modules/lcd-panel/lcd-panel.kicad_pcb

## KiCad design modules/lcd-panel/lcd-panel.kicad_pcb (2025-04-25)

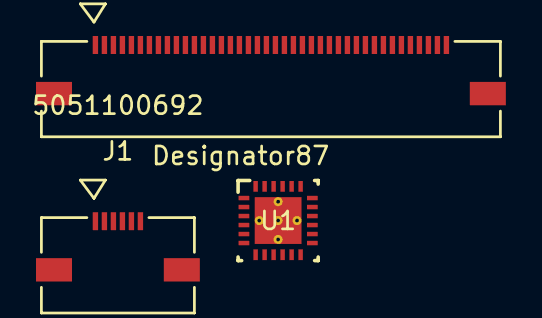
[picture p27: board lcd-panel.kicad_pcb from above]

Board: 2 copper layers, 3 parts (0 on the bottom side), 4 nets, no tracks yet.

Parts:
J1: 5051100692; CON_5051100692_MOL
J2: 5051104091; CON_5051104091_MOL
U1: LP8556SQ-E09/NOPB; RTW0024A

Connections:
GND: J1.P1, J1.P2, J2.3, J2.29, J2.36, J2.P1, J2.P2, U1.3 (GND_SW), U1.4 (GND_SW), U1.10 (GND), U1.11 (GND), U1.15 (GND), U1.21 (FSET), U1.24 (GND), U1.25 (GND)
LEDA: J2.2, U1.20 (VBOOST)
LEDK: J2.1, U1.12 (LED1)
unnamed: U1.1 (SW), U1.2 (SW)
