gardners/megaphone-r5-modular/(commit log)

2025-02-25 finish SD and SIM card holder footprint and symbol
    [sim-and-sd-card.kicad_pcb, sim-and-sd-card.kicad_sch]
2025-02-28 reverse text direction for part labels on DC:DC
    [high-efficiency_dc-dc_converter.kicad_pcb]
2025-02-28 exported gerbers for SIM SD card module
    [sim-and-sd-card.kicad_pcb]
2025-03-01 add footprints for USB-C power in
2025-03-01 begin working on usb-c power in module
    [usb-c-power-in.kicad_pcb, usb-c-power-in.kicad_sch]
2025-03-01 finish usb-c power in module and generate gerbers
    [usb-c-power-in.kicad_pcb, usb-c-power-in.kicad_sch]
2025-03-01 add footprints for MOSFETs for input power selecter
    [usb-c-power-in.kicad_pcb, usb-c-power-in.kicad_sch]
2025-03-01 begin work on input power selecter
    [input-power-selector.kicad_pcb, input-power-selector.kicad_sch]
2025-03-01 begin laying out DC input selector
    [input-power-selector.kicad_sch]
2025-03-01 add symbols and footprints for input power selector components
    [input-power-selector.kicad_sch]
2025-03-01 more input power selector footprints
    [TSM4800N15CX6RFG.STEP, TSM4800N15CX6RFG.step]
2025-03-01 add models for N-channel MOSFET
    [IPF067N20NM6ATMA1.stp]
2025-03-01 add more footprints etc
    [SMM4F24A-TR.step, input-power-selector.kicad_pcb]
2025-03-01 finish laying out schematic for power selector input protection
    [input-power-selector.kicad_sch]
2025-03-02 add models for simple Zener diode
    [BZX384-C30_115.step]
2025-03-02 prepare for pcb layout for power selector
    [input-power-selector.kicad_pcb, input-power-selector.kicad_sch]
2025-03-04 add footprints for SMCJ28A. work on reverse polarity protection
    [input-power-selector.kicad_sch]
2025-03-04 work on laying out power input selector
    [input-power-selector.kicad_pcb, input-power-selector.kicad_sch]
2025-03-04 more layout fixing on power selector
    [input-power-selector.kicad_pcb, input-power-selector.kicad_sch]
2025-03-04 add models etc for more components
    [PowerPAK_8x8L_BWL-2_VIS.step, SMCJSeries_LTF.step]
2025-03-04 add missing 3D model
    [SOIC_09DY-T1-GE3_VIS.step]
2025-03-04 update input source selecter PCB layout
    [input-power-selector.kicad_pcb, input-power-selector.kicad_sch]
2025-03-04 add module outline for input source selecter
    [input-power-selector.kicad_pcb, input-power-selector.kicad_sch]
2025-03-04 fix remaining important DRC violations
    [input-power-selector.kicad_pcb]
2025-03-05 add symbols for 2-pin internal solar panel
    [S2B-PH-K-S.STEP]
2025-03-05 add footprints for DC barrel jack
    [54-00127.step]
2025-03-05 begin working on solar and DC power input module
    [solar-and-dc-connectors.kicad_pcb, solar-and-dc-connectors.kicad_sch]
2025-03-05 add footprints for battery screw terminal
    [691210910002.step]
2025-03-05 add missing footprints and symbols
    [input-power-selector.kicad_pcb, input-power-selector.kicad_sch, solar-and-dc-connectors.kicad_pcb, solar-and-dc-connectors.kicad_sch]
2025-03-05 begin work on battery connector module
    [battery-connector.kicad_pcb, battery-connector.kicad_sch]
2025-03-05 add footprint for battery power connector module
2025-03-05 work on battery connector module
    [battery-connector.kicad_pcb, battery-connector.kicad_sch]
2025-03-05 finish battery connector module design
    [battery-connector.kicad_pcb, battery-connector.kicad_sch]
2025-04-25 update mppt charger submodule
2025-04-25 fix requirement numbering transposition
    [requirements.csv]
2025-04-25 make CSV file actually be CSV
    [requirements.csv]
2025-04-25 quote requirements text
    [requirements.csv]
2025-04-25 add header to requirements table
    [requirements.csv]
2025-04-25 work on bomtool schematic parser
2025-04-25 ignore power symbols
2025-04-25 begin making library to track parts
2025-04-25 get oauth working, but flow is still broken
2025-04-25 work on parser for BM83 UART packets
2025-04-25 fix bm83 uart rx framing
2025-04-25 downgrade requirement 2.1.2 to desirable
    [requirements.csv]
2025-04-25 add footprints for BM83
    [BM83SM1-00AA.step]
2025-04-25 begin work on bluetooth module
    [bluetooth.kicad_pcb, bluetooth.kicad_sch]
2025-04-25 begin work on lcd panel modeul
    [RTW0024A.stp, lcd-panel.kicad_pcb, lcd-panel.kicad_sch]
2025-04-25 update bluetooth module
    [bluetooth.kicad_pcb, bluetooth.kicad_sch]
2025-04-25 update footprints file
2025-04-25 add footprints etc for LCD cable connectors
    [5051100692.stp, 5051104091.stp]
2025-04-25 more work on lcd panel module
    [lcd-panel.kicad_pcb, lcd-panel.kicad_sch]
2025-04-25 first cut at adding "backup vias" for footprints
2025-04-25 update offset of spare hole for pads
2025-04-25 fix sparepad footprint problems
2025-04-25 fix typo in footprint-gen.c
2025-06-13 Updating PART NOs
    [cellular-modem.kicad_sch]
2025-06-13 Adding more mouser parts to schematics
    [high-efficiency_dc-dc_converter.kicad_sch, mems-microphone.kicad_sch, solar-and-dc-connectors.kicad_sch]
2025-06-13 Adding Mouser parts to power selector
    [input-power-selector.kicad_sch]
2025-06-13 Adding Mouser parts to sc
    [audio-codec.kicad_sch]
2025-06-13 Updating parts
    [high-efficiency_dc-dc_converter.kicad_sch]
2025-06-13 fix pin numbers and shape for right half
2025-06-13 Updating cellular modem - adding KiCad git ignore
    [cellular-modem.kicad_pcb, cellular-modem.kicad_sch]
2025-06-13 Adding cellular modem footprints
2025-06-13 KiCad v9 adding new footprints
    [audio-jack.kicad_pcb, audio-jack.kicad_sch, battery-connector.kicad_pcb, battery-connector.kicad_sch, sim-and-sd-card.kicad_pcb, sim-and-sd-card.kicad_sch]
2025-06-13 Updating mems mic
    [mems-microphone.kicad_pcb, mems-microphone.kicad_sch]
2025-06-13 Updating high-efficiency_dc-dc_converter
    [high-efficiency_dc-dc_converter.kicad_pcb, high-efficiency_dc-dc_converter.kicad_sch]
2025-06-13 Updating solar-and-dc
    [solar-and-dc-connectors.kicad_pcb, solar-and-dc-connectors.kicad_sch]
2025-06-13 Updating USB-Power-IN
    [usb-c-power-in.kicad_pcb, usb-c-power-in.kicad_sch]
2025-06-13 Updating footprint on input power selector
    [input-power-selector.kicad_pcb, input-power-selector.kicad_sch]
2025-06-13 Update bluetooth
    [bluetooth.kicad_pcb, bluetooth.kicad_sch]
2025-06-13 update LCD module
    [lcd-panel.kicad_sch]
2025-06-13 update mppt-charge-controller
2025-06-22 begin implementing printing Unicode strings
2025-06-22 more work on UTF-8 Unicode string printer
